JCVis/GrowFacility/Manual/butane vs. breath.jpg

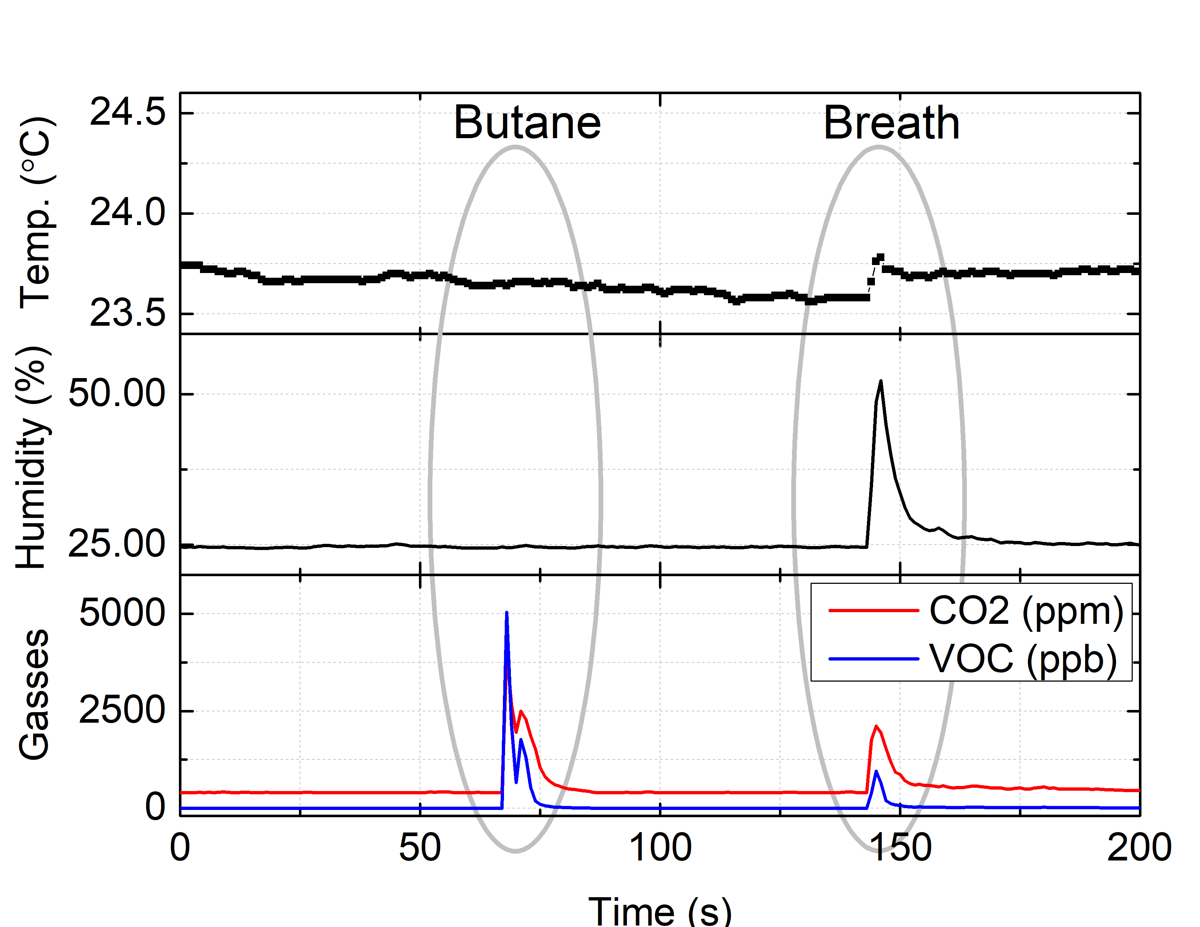
Manual/butane vs. breath.jpg
