JCVis/GrowFacility/Manual/leakage.jpg

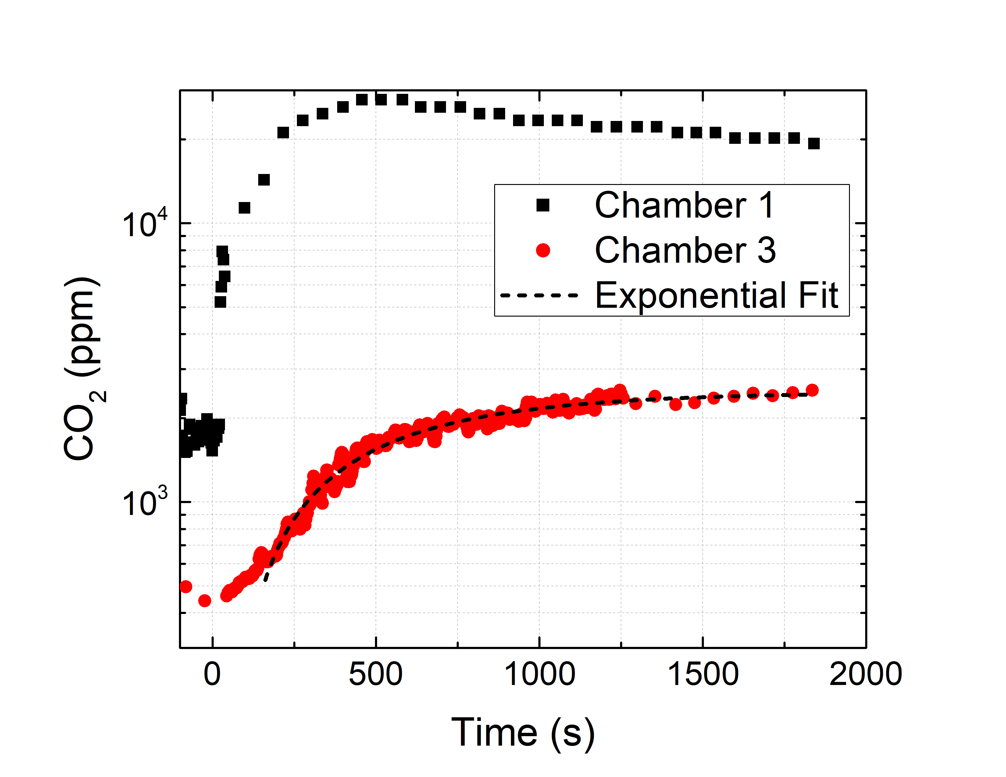
Manual/leakage.jpg
