JCVis/GrowFacility/Manual/Day measurement.jpg

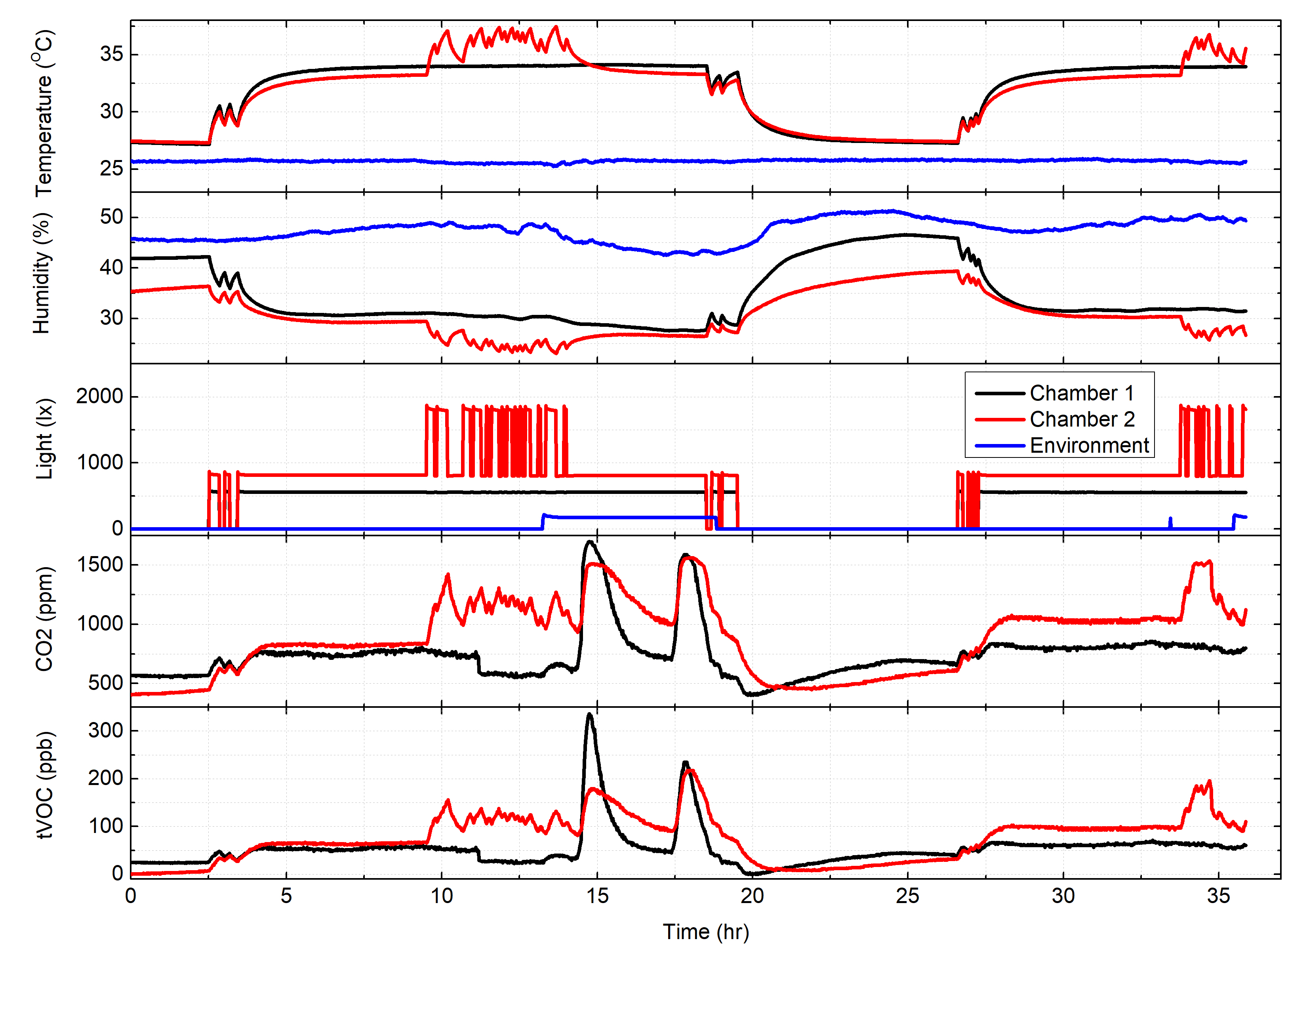
Manual/Day measurement.jpg
