JCVis/GrowFacility/Manual/Leak test.jpg

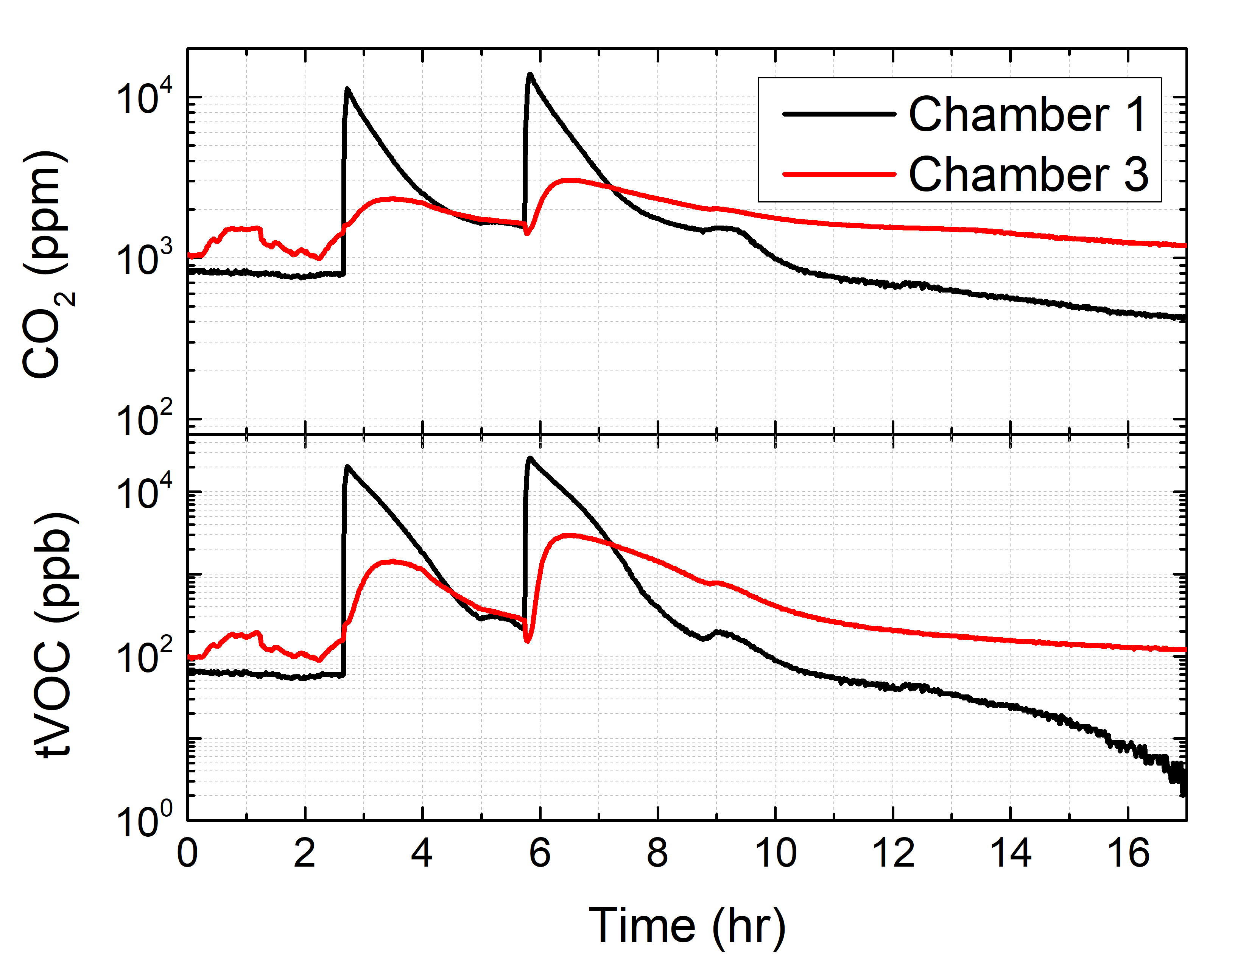
Manual/Leak test.jpg
