JCVis/GrowFacility/Manual/tomatoControl.pdf

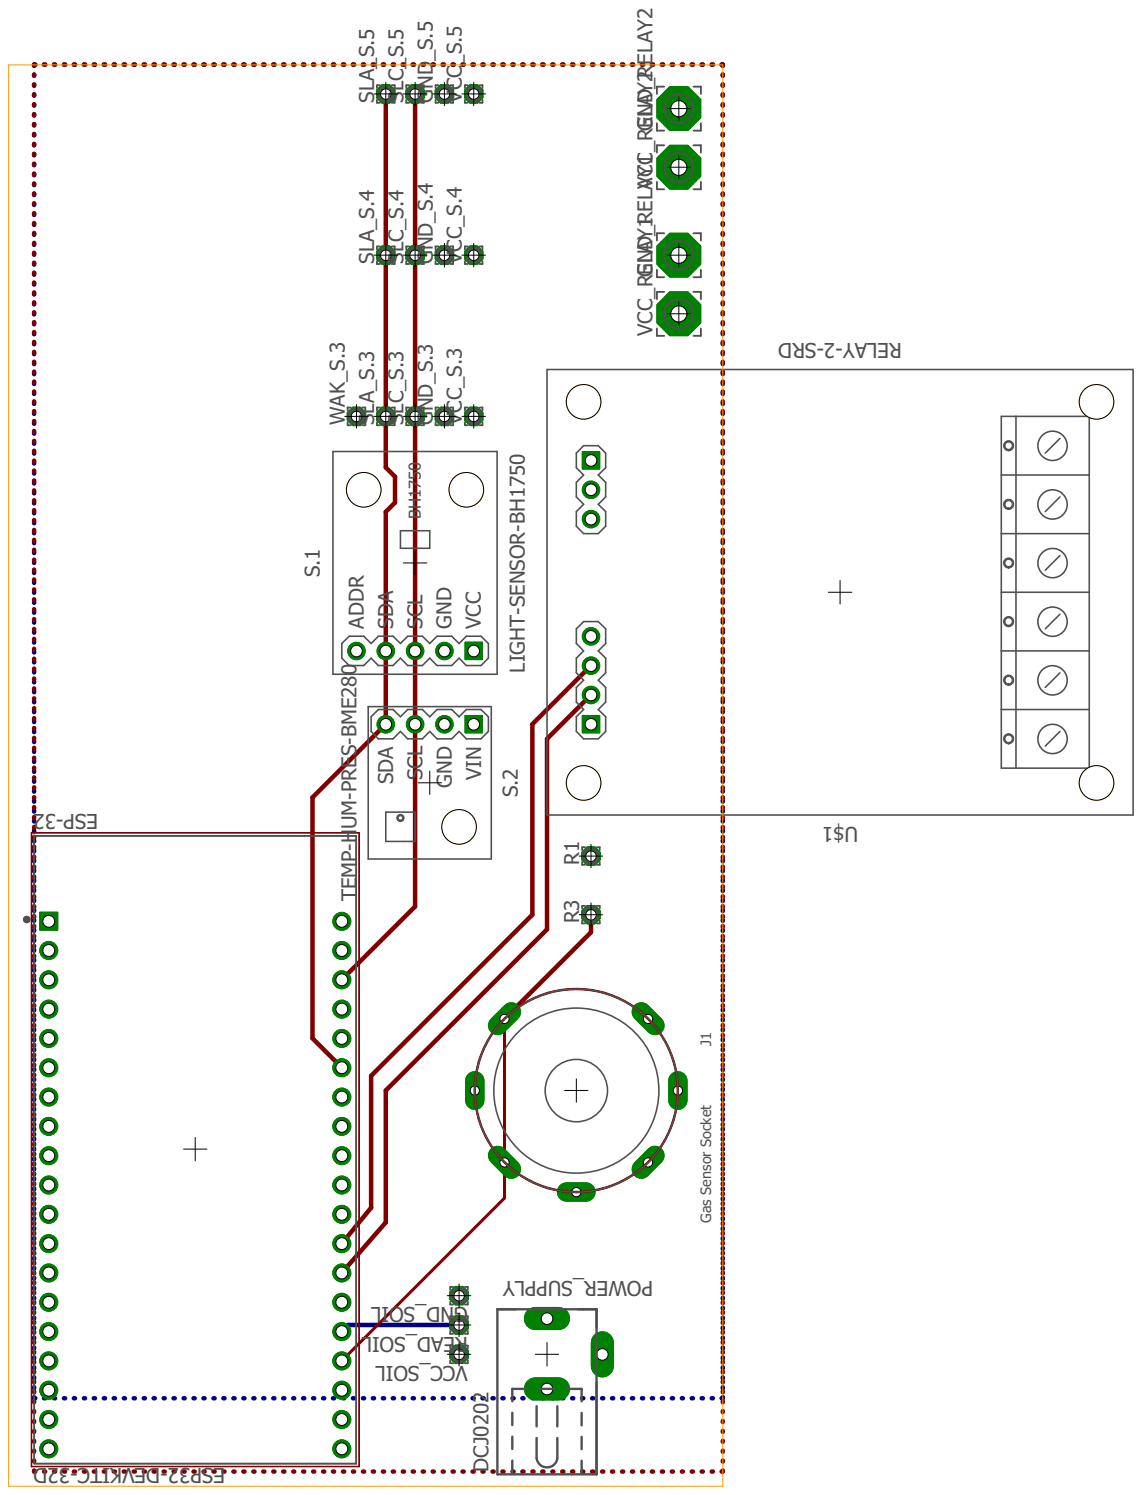
[picture p10: page 1]

SCL GND VIN SDA SCL SDA ADDR GND VCC BH1750 GND_S.3 GND_RELAY1 GND_RELAY2 GND_S.5 GND_S.4 LI OS_DNG J1 R1 R3 LI OS_DAER SLA_S.3 SLA_S.5 SLA_S.4 SLC_S.3 SLC_S.5 SLC_S.4 1$U S.2 S.1 23- PSE VCC_S.3 VCC_RELAY1 VCC_RELAY2 VCC_S.5 VCC_S.4 LI OS_CCV WAK_S.3 YLPPUS_RE WOP Gas Sensor Socket DRS- 2- YALER TEMP-HUM-PRES-BME280LIGHT-SENSOR-BH1750 D23- CTI KVED- 23PSE DCJ0202
